Ingwie/NextStepRc-2.18/README.md

 *************************************************************
 *                      NEXTSTEPRC                           *
 *                                                           *
 *             -> Build your DIY MEGA 2560 TX                *
 *                                                           *
 *      Based on code named                                  *
 *      OpenTx - https://github.com/opentx/opentx            *
 *                                                           *
 *         Only avr code here for lisibility ;-)             *
 *                                                           *
 *  License GPLv2: http://www.gnu.org/licenses/gpl-2.0.html  *
 *                                                           *
 *************************************************************
