Ingwie/NextStepRc-2.18/documentation/NextStepRC_M2560/1_Electronics/MEGA2560_PinMapping.xls

Pin Number | Pin Name | Arduino Mapped Pin Name | Port | Pin | Gruvin9x | MEGA2560 | Function | Gruvin9x |  | MEGA2560
1 | PG5 ( OC0B ) | Digital pin 4 (PWM) | A | 0 | LCD Data 0 | LCD Data 0 | LCD Data 0 | A | 0 | A | 0
2 | PE0 ( RXD0/PCINT8 ) | Digital pin 0 (PWM) (RX0) | A | 1 | LCD Data 1 | LCD Data 1 | LCD Data 1 | A | 1 | A | 1
3 | PE1 ( TXD0 ) | Digital pin 1 (PWM) (TX0) | A | 2 | LCD Data 2 | LCD Data 2 | LCD Data 2 | A | 2 | A | 2
4 | PE2 ( XCK0/AIN0 ) |  | A | 3 | LCD Data 3 | LCD Data 3 | LCD Data 3 | A | 3 | A | 3
5 | PE3 ( OC3A/AIN1 ) | Digital pin 5 (PWM) | A | 4 | LCD Data 4 | LCD Data 4 | LCD Data 4 | A | 4 | A | 4
6 | PE4 ( OC3B/INT4 ) | Digital pin 2 (PWM) | A | 5 | LCD Data 5 | LCD Data 5 | LCD Data 5 | A | 5 | A | 5
7 | PE5 ( OC3C/INT5 ) | Digital pin 3 (PWM) | A | 6 | LCD Data 6 | LCD Data 6 | LCD Data 6 | A | 6 | A | 6
8 | PE6 ( T3/INT6 ) |  | A | 7 | LCD Data 7 | LCD Data 7 | LCD Data 7 | A | 7 | A | 7
9 | PE7 ( CLKO/ICP3/INT7 ) |  | B | 0 | SD CARD | SD CARD | LCD BkL | C | 0 | C | 2
10 | VCC | VCC | B | 1 | SD CARD | SD CARD | LCD CS | C | 1 | C | 3
11 | GND | GND | B | 2 | SD CARD | SD CARD | LCD RST | C | 2 | C | 4
12 | PH0 ( RXD2 ) | Digital pin 17 (PWM) | B | 3 | SD CARD | SD CARD | LCD A0 | C | 3 | C | 5
13 | PH1 ( TXD2 ) | Digital pin 16 (PWM) | B | 4 | ID 2 SW | Unused | LCD WR | C | 4 | C | 6
14 | PH2 ( XCK2 ) | (TX3) | B | 5 | TRN SW | Sim control | LCD RD | C | 5 | C | 7
15 | PH3 ( OC4A ) | Digital pin 6 (PWM)(RX3 ) | B | 6 | PPM out | PPM out | Key down | L | 0 | L | 0
16 | PH4 ( OC4B ) | Digital pin 7 (PWM)(TX2) | B | 7 | Speaker | Voice_busy | Key up | L | 1 | L | 1
17 | PH5 ( OC4C ) | Digital pin 8 (PWM)(RX2 ) | C | 0 | LCD BkL | ID 1 SW | Key right | L | 2 | L | 2
18 | PH6 ( OC2B ) | Digital pin 9 (PWM)(TX1) | C | 1 | LCD CS | ID 2 SW | Key left | L | 3 | L | 3
19 | PB0 ( SS/PCINT0 ) | Digital pin 53 (PWM)(RX1) | C | 2 | LCD RST | LCD BkL | Key MENU | L | 4 | L | 4
20 | PB1 ( SCK/PCINT1 ) | Digital pin 52 (PWM)(SDA) | C | 3 | LCD A0 | LCD CS | Key ESC | L | 5 | L | 5
21 | PB2 ( MOSI/PCINT2 ) | Digital pin 51 (PWM)(SCL) | C | 4 | LCD WR | LCD RST | Stick RH | K | 0 | K | 0
22 | PB3 ( MISO/PCINT3 ) | Digital pin 50 | C | 5 | LCD RD | LCD A0 | Stick LV | K | 1 | K | 1
23 | PB4 ( OC2A/PCINT4 ) | Digital pin 10 (PWM) | C | 6 | ELE DR SW | LCD WR | Stick RV | K | 2 | K | 2
24 | PB5 ( OC1A/PCINT5 ) | Digital pin 11 (PWM) | C | 7 | AIL DR SW | LCD RD | Stick LH | K | 3 | K | 3
25 | PB6 ( OC1B/PCINT6 ) | Digital pin 12 (PWM) | D | 0 | I2C_SCL | I2C_SCL | Pot 1 | K | 4 | K | 4
26 | PB7 ( OC0A/OC1C/PCINT7 ) | Digital pin 13 (PWM) | D | 1 | I2C_SDA | I2C_SDA | Pot 2 | K | 5 | K | 5
27 | PH7 ( T4 ) |  | D | 2 | Rot 2 A | Rot 2 A | Pot 3 | K | 6 | K | 6
28 | PG3 ( TOSC2 ) |  | D | 3 | Rot 2 B | Rot 2 B | U Batt | K | 7 | K | 7
29 | PG4 ( TOSC1 ) |  | D | 4 | Rot 1 push | - | LH_Trim_dwn | J | 0 | F | 7
30 | RESET | RESET | D | 5 | Rot 2 push | - | LH_Trim_up | J | 1 | F | 6
31 | VCC | VCC | D | 6 | Spare 1 | - | LV_Trim_dwn | J | 2 | F | 5
32 | GND | GND | D | 7 | Spare 2 | AIL DR SW | LV_Trim_up | J | 3 | F | 4
33 | XTAL2 | XTAL2 | E | 0 | Telemetry in | Telemetry in | RV_Trim_dwn | J | 4 | F | 3
34 | XTAL1 | XTAL1 | E | 1 | Telemetry out | Telemetry out | RV_Trim_up | J | 5 | F | 2
35 | PL0 ( ICP4 ) | Digital pin 49 | E | 2 | USB_D- | - | RH_Trim_dwn | J | 6 | F | 1
36 | PL1 ( ICP5 ) | Digital pin 48 | E | 3 | Buzzer | Voice_data | RH_Trim_up | J | 7 | F | 0
37 | PL2 ( T5 ) | Digital pin 47 | E | 4 | USB_D+ | Rot 1 A | ID 1 SW | G | 3 | C | 0
38 | PL3 ( OC5A ) | Digital pin 46 (PWM) | E | 5 | Rot 1 A | Rot 1 B | ID 2 SW | B | 4 | C | 1
39 | PL4 ( OC5B ) | Digital pin 45 (PWM) | E | 6 | Rot 1 B | - | TRN SW | B | 5 | L | 7
40 | PL5 ( OC5C ) | Digital pin 44 (PWM) | E | 7 | PPM in | PPM in | AIL DR SW | C | 7 | D | 7
41 | PL6 | Digital pin 43 | F | 0 | - | RH_Trim_up | ELE DR SW | C | 6 | L | 6
42 | PL7 | Digital pin 42 | F | 1 | - | LH_Trim_dwn | RUD DR SW | G | 0 | G | 0
43 | PD0 ( SCL/INT0 ) | Digital pin 21 (SCL) | F | 2 | - | RV_Trim_up | GEAR SW | G | 5 | G | 1
44 | PD1 ( SDA/INT1 ) | Digital pin 20 (SDA) | F | 3 | - | RV_Trim_dwn | THR CUT SW | G | 2 | G | 2
45 | PD2 ( RXDI/INT2 ) | Digital pin 19 | F | 4 | - | LV_Trim_up | Rot 1 A | E | 5 | E | 4
46 | PD3 ( TXD1/INT3 ) | Digital pin 18 | F | 5 | - | LV_Trim_dwn | Rot 1 B | E | 6 | E | 5
47 | PD4 ( ICP1 ) |  | F | 6 | - | LH_Trim_up | Rot 1 push | D | 4 | J | 0
48 | PD5 ( XCK1 ) |  | F | 7 | - | LH_Trim_dwn | Rot 2 A | D | 2 | D | 2
49 | PD6 ( T1 ) |  | G | 0 | RUD DR SW | RUD DR SW | Rot 2 B | D | 3 | D | 3
50 | PD7 ( T0 ) | Digital pin 38 | G | 1 | RF activated | GEAR SW | Rot 2 push | D | 5 | J | 1
51 | PG0 ( WR ) | Digital pin 41 | G | 2 | THR CUT SW | THR CUT SW | Buzzer | E | 3 | H | 3
52 | PG1 ( RD ) | Digital pin 40 | G | 3 | ID 1 SW | - | Speaker | B | 7 | H | 3
53 | PC0 ( A8 ) | Digital pin 37 | G | 4 | Sim control | - | Haptic (vib) | H | 2 | H | 0
54 | PC1 ( A9 ) | Digital pin 36 | G | 5 | Gear SW | Voice_clock | Voice_reset | H | 3 | H | 1
55 | PC2 ( A10 ) | Digital pin 35 | G | 6 | - | - | Voice_clock | H | 4 | G | 5
56 | PC3 ( A11 ) | Digital pin 34 | G | 7 | - | - | Voice_data | H | 5 | E | 3
57 | PC4 ( A12 ) | Digital pin 33 | H | 0 | - | Haptic (vib) | Voice_busy | H | 6 | B | 7
58 | PC5 ( A13 ) | Digital pin 32 | H | 1 | - | Voice_reset | PPM out | B | 6 | B | 6
59 | PC6 ( A14 ) | Digital pin 31 | H | 2 | Haptic (vib) | - | PPM in | E | 7 | E | 7
60 | PC7 ( A15 ) | Digital pin 30 | H | 3 | Voice_reset | Speaker/Buzzer | Sim control | G | 4 | B | 5
61 | VCC | VCC | H | 4 | Voice_clock | Hold power | Hold power | L | 7 | H | 4
62 | GND | GND | H | 5 | Voice_data | DSC activated | DSC activated | L | 6 | H | 5
63 | PJ0 ( RXD3/PCINT9 ) | Digital pin 15 | H | 6 | Voice_busy | RF activated | RF activated | G | 1 | H | 6
64 | PJ1 ( TXD3/PCINT10 ) | Digital pin 14 | H | 7 | - | - | Telemetry in | E | 0 | E | 0
65 | PJ2 ( XCK3/PCINT11 ) |  | I | 0 | - | - | Telemetry out | E | 1 | E | 1
66 | PJ3 ( PCINT12 ) |  | I | 1 | - | - | SD CARD | B | 0 | B | 0
67 | PJ4 ( PCINT13 ) |  | I | 2 | - | - | SD CARD | B | 1 | B | 1
68 | PJ5 ( PCINT14 ) |  | I | 3 | - | - | SD CARD | B | 2 | B | 2
69 | PJ6 ( PCINT 15 ) |  | I | 4 | - | - | SD CARD | B | 3 | B | 3
70 | PG2 ( ALE ) | Digital pin 39 | I | 5 | - | - | I2C_SCL | D | 0 | D | 0
71 | PA7 ( AD7 ) | Digital pin 29 | I | 6 | - | - | I2C_SDA | D | 1 | D | 1
72 | PA6 ( AD6 ) | Digital pin 28 | I | 7 | - | -
73 | PA5 ( AD5 ) | Digital pin 27 | J | 0 | LH_Trim_dwn | Rot 1 push
74 | PA4 ( AD4 ) | Digital pin 26 | J | 1 | LH_Trim_up | Rot 2 push
75 | PA3 ( AD3 ) | Digital pin 25 | J | 2 | LV_Trim_dwn | -
76 | PA2 ( AD2 ) | Digital pin 24 | J | 3 | LV_Trim_up | -
77 | PA1 ( AD1 ) | Digital pin 23 | J | 4 | RV_Trim_dwn | -
78 | PA0 ( AD0 ) | Digital pin 22 | J | 5 | RV_Trim_up | -
79 | PJ7 |  | J | 6 | RH_Trim_dwn | -
80 | VCC | VCC | J | 7 | RH_Trim_up | -
81 | GND | GND | K | 0 | Stick RH | Stick RH
82 | PK7 ( ADC15/PCINT23 ) | Analog pin 15 | K | 1 | Stick LV | Stick LV
83 | PK6 ( ADC14/PCINT22 ) | Analog pin 14 | K | 2 | Stick RV | Stick RV
84 | PK5 ( ADC13/PCINT21 ) | Analog pin 13 | K | 3 | Stick LH | Stick LH
85 | PK4 ( ADC12/PCINT20 ) | Analog pin 12 | K | 4 | Pot 1 | Pot 1
86 | PK3 ( ADC11/PCINT19 ) | Analog pin 11 | K | 5 | Pot 2 | Pot 2
87 | PK2 ( ADC10/PCINT18 ) | Analog pin 10 | K | 6 | Pot 3 | Pot 3
88 | PK1 ( ADC9/PCINT17 ) | Analog pin 9 | K | 7 | U Batt | U Batt
89 | PK0 ( ADC8/PCINT16 ) | Analog pin 8 | L | 0 | Key down | Keys
90 | PF7 ( ADC7/PCINT15 ) | Analog pin 7 | L | 1 | Key up | Keys
91 | PF6 ( ADC6/PCINT14 ) | Analog pin 6 | L | 2 | Key right | Keys
92 | PF5 ( ADC5/TMS ) | Analog pin 5 | L | 3 | Key left | Keys
93 | PF4 ( ADC4/TMK ) | Analog pin 4 | L | 4 | Key MENU | Key MENU
94 | PF3 ( ADC3 ) | Analog pin 3 | L | 5 | Key ESC | Key ESC
95 | PF2 ( ADC2 ) | Analog pin 2 | L | 6 | DSC activated | ELE DR SW
96 | PF1 ( ADC1 ) | Analog pin 1 | L | 7 | Hold power | TRN SW
97 | PF0 ( ADC0 ) | Analog pin 0
98 | AREF | Analog Reference
99 | GND | GND
100 | AVCC | VCC
