Ingwie/NextStepRc-2.18/documentation/NextStepRC_M2560/1_Electronics/KS108(fr).xls

MEGA2560 | KS108
Lcd_Data_0 | DB0
Lcd_Data_1 | DB1
Lcd_Data_2 | DB2
Lcd_Data_3 | DB3
Lcd_Data_4 | DB4
Lcd_Data_5 | DB5
Lcd_Data_6 | DB6
Lcd_Data_7 | DB7
Lcd_RD | E
Lcd_WR | CS2 (ou CS1 si affichage inversé)
Lcd_A0 | D/I (ou RS)
Lcd_RST | RST
Lcd_CS | CS1 (ou CS2 si affichage inversé)
Lcd_Light | A (via une résistance de 100 ohms), K à la masse. ou montage à transistor)
 | R/W : Non connectée au méga. Reliée à la masse via une résistance de 1kohms
 | VSS (masse)
 | VDD (+5V)
 | VEE (voir schéma)
 | VR (voir schéma)
