Ingwie/NextStepRc-2.18/documentation/NextStepRC_M2560/1_Electronics/MEGA2560_Listing.xls

Board | Label | Qty | Manufacturer | Part Number | Description | Case | Implantation | Side | Points | Total pts | Comment
- | - | 1 | - | - | 2 mm plywood 250 x 500 mm | - | - | - | - | - | Prefere marine or aircraft plywood
- | - | 1 | Funduino, SaintSmart | MEGA2560 | Arduino Mega2560 clone (http://www.ebay.fr/itm/291335218312) | - | - | - | - | - | Main board (prefer with CH340G serial driver) (http://www.ebay.fr/itm/151303481964)
- | - | 2 | Samsung, Panasonic, etc. | - | 18650 round Li-Ion with PCB (http://fr.aliexpress.com/item/-/32257563308.html) | - | - | - | - | - | 2400 to 3400 mAh
- | - | 1 | - | - | HF module (2.4 GHz, 433 MHz, etc.) | - | - | - | - | - | PPM positive or negative shift, up to 16 channels + telemetry
- | - | 0 to 1 | - | - | RS232 to TTL converter (MAX3232) (http://www.ebay.fr/itm/221484714177) | - | - | - | - | - | For FrSky telemetry (if no "direct TTL" modification)
- | - | 1 | - | - | USBASP programmer (http://www.ebay.com/sch/i.html?_from=R40&_nkw=usbasp&_sacat=0) | - | - | - | - | - | For bootloader and fuses flash
- | - | 1 | Artronic | 128064MN19-FHW | LCD 128x64 ST7565R (http://www.ebay.fr/itm/321632747032) | - | - | - | - | - | LCD (large, 3.3V, to use with M2560-1 board)
- | - | 1 | Zolen | ZLE12864A | LCD 128x64 ST7565P (http://fr.aliexpress.com/item/4pcs-New-12864-128x64-Graphic-LCD-Display-module-ST7565P-Free-Shipping/1383335383.html) | - | - | - | - | - | LCD (small, 5V)
- | - | 1 | Turnigy | 9171000250 | 9XR gimbal left (http://www.hobbyking.com/hobbyking/store/__39505__transmitter_gimbal_set_left_turnigy_9xr_transmitter_mode_1.html) | - | - | - | - | - | Gimbal basic (direct connection on MEGA)
- | - | 1 | Turnigy | 9171000248 | 9XR gimbal right (http://www.hobbyking.com/hobbyking/store/__39503__Transmitter_Gimbal_Set_Right_Turnigy_9XR_Transmitter_Mode_1.html) | - | - | - | - | - | Gimbal basic (direct connection on MEGA)
- | - | 2 | Hitec | - | Aurora9 gimbal (http://www.robotshop.com/en/axis-joystick-gim.html) | - | - | - | - | - | Gimbal option (to use with M2560-5 board)
 | - | 0 to 2 | - | - | PS2 gimbal (http://www.aliexpress.com/item/Free-Shipping-20PCS-LOT-Dual-axis-XY-Joystick-Module-For-Arduino-ps2-Joystick-Module/1882818018.html) | - | - | - | - | - | Gimbal option
- | - | 1 | Turnigy | 9171000045 | M3 sticks pair (http://www.hobbyking.com/hobbyking/store/__23754__Alloy_Anti_Slip_TX_Control_Sticks_Short_Futaba_TX_.html) | - | - | - | - | - | Fit basic or option gimbal
- | - | 0 to 1 | - | - | on-off-on switch | - | - | - | - | - | ID0/1/2 switch
- | - | 0 to 5 | - | - | off-on switch | - | - | - | - | - | DR_e, DR_a, DR_r, ThCut, Gear switches
- | - | 0 to 1 | - | - | off-(on) switch | - | - | - | - | - | TRN (momentary, classic switch)
- | - | 0 to 1 | APEM | MJTP1230 | SPST tactile switch | - | - | - | - | - | TRN (momentary, small swtich), or other(s) switch(es) with T flip-flop virtual switch
- | - | 1 | ALPS | SKQUAAA010 | 4 way navigation switch | - | - | - | - | - | 4 way navigation (if no scroll navigation with M2560-1&2 boards)
- | - | 0 or 2 | APEM | MJTP1230 | SPST tactile switch | - | - | - | - | - | OK/ESC buttons (if no scroll navigation with M2560-1&2 boards)
- | - | 3 | - | - | JST BEC female connector plug | - | - | - | - | - | Charge or external supply connecteur + internal power wiring
- | - | 1 | - | - | JST BEC male connector plug | - | - | - | - | - | Internal power wiring
- | SW1 | 1 | Multicomp | R13-548B-05-BB | SPST push-button | - | - | - | - | - | Main power swtitch (basic)
- | SW1 | 1 | - | - | SPST metal + led push-button (http://www.ebay.fr/sch/i.html?_from=R40&_sacat=0&_nkw=metal+led+switch&_sop=15) | - | - | - | - | - | Main power swtitch (option)
- | - | 0.5 m | - | - | 28 or 30 AWG flap ribbon cable, 20 wires | - | - | - | - | - | LCD, switches and rotary encoders wiring
- | - | 1 | DB Products | PK-21N30-WQ | Piezoelectronic buzzer | - | - | - | - | - | Buzzer with built-in drive circuit
- | - | 0 to 1 | - | - | Mini SD-Card socket for Arduino (http://www.ebay.fr/itm/221485468743) | - | - | - | - | - | Option
- | - | 0 to 1 | - | - | Real Time Clock (http://www.ebay.fr/itm/251730989006) | - | - | - | - | - | Option
M2560-1_LCD | Q1 | 1 | ON Semiconductor | MMFT960T1 | 300 mA 60 Volts N−Channel MOSFET | SOT-223 | SMD | Top | 4 | 4
M2560-1_LCD | U3 | 1 | Microchip | MCP1826S3302 | 3.3V 1A Low drop positive regulator | SOT-223 | SMD | Top | 4 | 4
M2560-1_LCD | R4 | 14 | - | - | 5.1 Kohms 1% resistor | 1206 | SMD | Top | 2 | 28
M2560-1_LCD | R6 | 14 | - | - | 10 Kohms 1% resistor | 1206 | SMD | Top | 2 | 28
M2560-1_LCD | C1 | 2 | - | - | 100 nF 10% 63 V Capacitor X7R | 1206 | SMD | Top | 2 | 4
M2560-2_RotEnc1 | - | 1 | C&K | TSWB-3N-CB111 LFS | 4 ways navigation switch + scroll + pushbutton | - | Through hole | Bottom | 9 | 9 | Rotary encoder 1 & navigation (arrows + Menu)
M2560-2_RotEnc1 | R1 | 7 | - | - | 200 ohms 1% resistor | 1206 | SMD | Top | 2 | 14
M2560-2_RotEnc1 | R4 | 2 | - | - | 5.1 Kohms 1% resistor | 1206 | SMD | Top | 2 | 4
M2560-2_RotEnc1 | C1 | 7 | - | - | 100 nF 10% 63 V Capacitor X7R | 1206 | SMD | Top | 2 | 14
M2560-3_RotEnc2 | - | 1 | C&K | TSWA-3N-CB11 LFS | Scroll + pushbutton | - | Through hole | Bottom | 4 | 4 | Rotary encoder 2 & navigation (Esc) or alone rotary (Rot_x + Push_x)
M2560-3_RotEnc2 | R1 | 3 | - | - | 200 ohms 1% resistor | 1206 | SMD | Top | 2 | 6
M2560-3_RotEnc2 | R4 | 2 | - | - | 5.1 Kohms 1% resistor | 1206 | SMD | Top | 2 | 4
M2560-3_RotEnc2 | C1 | 3 | - | - | 100 nF 10% 63 V Capacitor X7R | 1206 | SMD | Top | 2 | 6
M2560-4_Trim&switches | - | 2 | ALPSS | SKQUAAA01 | 4 ways navigation swtich | - | Through hole | Bottom | 6 | 12
M2560-4_Trim&switches | R1 | 8 | - | - | 200 ohms 1% resistor | 1206 | SMD | Top | 2 | 16
M2560-4_Trim&switches | C1 | 8 | - | - | 100 nF 10% 63 V Capacitor X7R | 1206 | SMD | Top | 2 | 16
M2560-5_Sticks(basic) | - | 4 | TE Connectivity | 292161-3 | 2 mm 3 pins connector header | - | Through hole | Bottom | 3 | 12
M2560-5_Sticks(basic) | - | 1 | - | - | 2.54 mm connector header | - | Through hole | Top | 4 | 4 | 4 pins
M2560-5_Sticks(basic) | U2 | 1 | Microchip | MCP6004 | Low-Power Op Amp | SOIC-14 | SMC | Top | 14 | 14
M2560-5_Sticks(basic) | R2 | 4 | - | - | 2.2 Kohms 1% resistor | 1206 | SMD | Top | 2 | 8
M2560-5_Sticks(basic) | R6 | 8 | - | - | 10 Kohms 1% resistor | 1206 | SMD | Top | 2 | 16
M2560-5_Sticks(full) | - | 4 | TE Connectivity | 292161-3 | 2 mm 3 pins connector header | - | Through hole | Bottom | 3 | 12
M2560-5_Sticks(full) | - | 1 | - | - | 2.54 mm connector header | - | Through hole | Top | 4 | 4 | 21 pins
M2560-5_Sticks(full) | U2 | 1 | Microchip | MCP6004 | Low-Power Op Amp | SOIC-14 | SMC | Top | 14 | 14
M2560-5_Sticks(full) | R2 | 4 | - | - | 2.2 Kohms 1% resistor | 1206 | SMD | Top | 2 | 8
M2560-5_Sticks(full) | R3 | 1 | - | - | 2.7 Kohms 1% resistor | 1206 | SMD | Top | 2 | 2
M2560-5_Sticks(full) | R4 | 1 | - | - | 5.1 Kohms 1% resistor | 1206 | SMD | Top | 2 | 2
M2560-5_Sticks(full) | R6 | 8 | - | - | 10 Kohms 1% resistor | 1206 | SMD | Top | 2 | 16
M2560-6_PPM&Power | - | 1 | - | - | 2.54 mm connector header | - | Through hole | Bottom | 4 | 4 | 33 pins
M2560-6_PPM&Power | U1 | 1 | On Semiconductor | MC14066B | Quad multiplexer | SOIC-14 | SMD | Top | 14 | 14 | Trainer port selector (in / out)
M2560-6_PPM&Power | Q1 | 1 | ON Semiconductor | MMFT960T1 | 300 mA 60 Volts N−Channel MOSFET | SOT-223 | SMD | Top | 4 | 4
M2560-6_PPM&Power | Q2 | 1 | Fairchild Semicon. | NDT2955 | 2.5 A 60 Volts P−Channel MOSFET | SOT-223 | SMD | Top | 4 | 4
M2560-6_PPM&Power | D1 | 4 | MCC | MBR0520LT1G | 0.5 A 20 V low drop Schottky | SOD-123 | SMD | Top | 2 | 8
M2560-6_PPM&Power | R1 | 1 | - | - | 200 ohms 1% resistor | 1206 | SMD | Top | 2 | 2
M2560-6_PPM&Power | R3 | 1 | - | - | 2.7 Kohms 1% resistor | 1206 | SMD | Top | 2 | 2
M2560-6_PPM&Power | R4 | 5 | - | - | 5.1 Kohms 1% resistor | 1206 | SMD | Top | 2 | 10
M2560-6_PPM&Power | R5 | 2 | - | - | 6.8 Kohms 1% resistor | 1206 | SMD | Top | 2 | 4
M2560-6_PPM&Power | R6 | 2 | - | - | 10 Kohms 1% resistor | 1206 | SMD | Top | 2 | 4
M2560-6_PPM&Power | R7 | 2 | - | - | 100 Kohms 1% resistor | 1206 | SMD | Top | 2 | 4
M2560-6_PPM&Power | C1 | 1 | - | - | 100 nF 10% 63 V Capacitor X7R | 1206 | SMD | Top | 2 | 2
M2560-6_PPM&Power | SW2 | 1 | CUI Inc | MD-40SV | Mini DIN 4 pins socket | - | - | - | - | - | Trainer port
M2560-6_PPM&Power | SW2 | 1 | CUI Inc | MD-40 | Mini DIN 4 pins plug | - | - | - | - | - | Trainer port
