Ingwie/NextStepRc-2.18/(list of files, cad)

Other CAD files:
documentation/NextStepRC_M2560/2_Case/MEGA2560_Case.dxf
