Ingwie/NextStepRc-2.18/documentation/NextStepRC_M2560/3_Flashing/MEGA2560_FlashProcedure.pdf

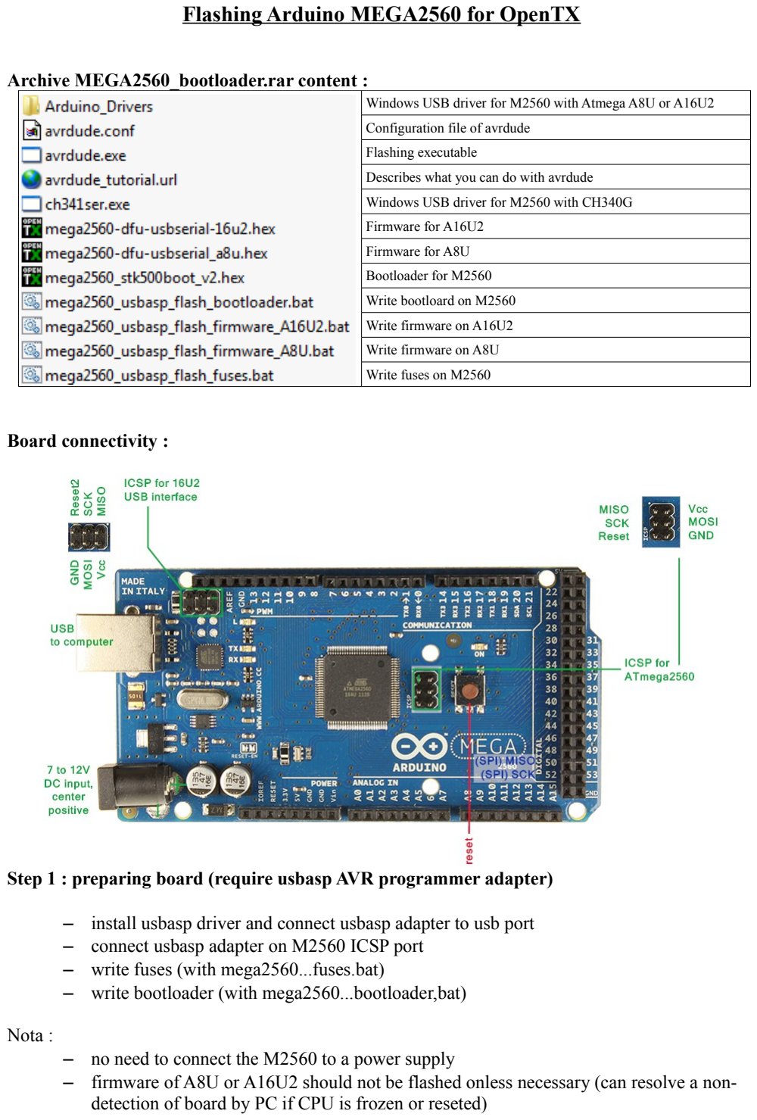
[picture p3: page 1]

Flashing Arduino MEGA2560 for OpenTX

Archive MEGA2560_bootloader.rar content :
Windows USB driver for M2560 with Atmega A8U or A16U2 Configuration file of avrdude
Flashing executable
Describes what you can do with avrdude
Windows USB driver for M2560 with CH340G Firmware for A16U2
Firmware for A8U
Bootloader for M2560
Write bootloard on M2560
Write firmware on A16U2
Write firmware on A8U
Write fuses on M2560

Board connectivity :

Step 1 : preparing board (require usbasp AVR programmer adapter)

– install usbasp driver and connect usbasp adapter to usb port – connect usbasp adapter on M2560 ICSP port
– write fuses (with mega2560...fuses.bat)
– write bootloader (with mega2560...bootloader,bat)

Nota :
– no need to connect the M2560 to a power supply
– firmware of A8U or A16U2 should not be flashed onless necessary (can resolve a nondetection of board by PC if CPU is frozen or reseted)

Step 2 : connecting board to USB
CH340G board | A8U or A16U2 board
- execute « ch341ser.exe » to install driver • connect M2560 on one USB port • Windows should automatically configure driver | • connect M2560 on one USB port • Windows opens an installation panel • choose manually the driver « arduino.inf » in the folder « Arduino_Drivers » provided

– verify on Windows device management (direct access : devmgmt.msc) if device works, and witch com is used (com1, com2, etc.)

Step 3 : setting Companion communication

– launch OpenTX Companion 2.1
– open the « Configure communications » menu
– set the following parameters (with the right com) :

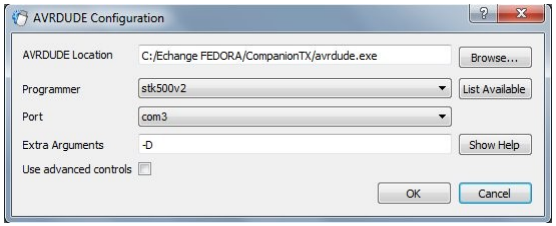
[picture p4: figure]

– A8U or A16U2 board : for each firmware or eeprom access (read or flash), M2560 must be reset just before (press reset button is board is already connected, or simply plug the board on USB)
– CH340G board : USB communication remains open after startup, no need to reset
Step 3 : setting Companion Radio Profile and and Application Settings

– go to the « Settings » menu, click « Settings »
– select « Radio Profile » tab
– check LCD, language and options needed :

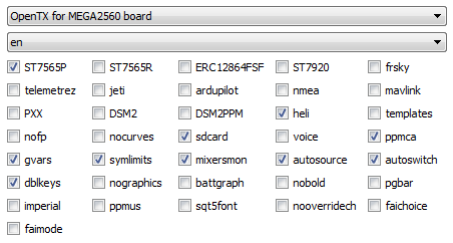
[picture p5: figure]

– select « Application Settings » tab
– open a folder for eeprom backup (don't check « Enable auto... » for the moment)
Step 4 : first flash with Companion

– go to « File » menu, click « Download »
– download firmware
– go to « Read/Write » menu, click « Write Firmware to Radio »
– load the downloaded firmware
– uncheck (for the moment) « Backup and restore Models ans Settings »

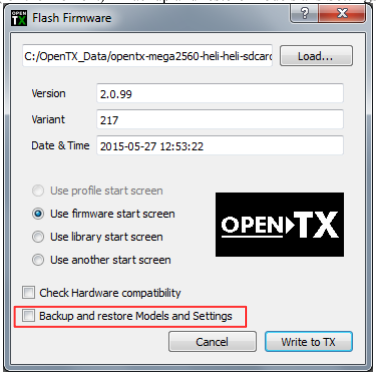
[picture p6: figure]

– write to TX...
– unplug the radio form USB port
– run the radio or plug it to usb port
– OpenTX should start and launch the init sequence (formatting eeprom then calibrate the sticks)
– enjoy... :)
