Ingwie/NextStepRc-2.18/documentation/NextStepRC_M2560/Readme.txt

Important note :

OpenTX-Mega2560 and NextStepRC projects are copyrighted under Creative Commons Attribution-NoDerivs licence (CC BY-ND).
For commercial purpose or derivated products, please contact the authors.
