Ingwie/NextStepRc-2.18/documentation/Other build link/Transmitter build by Mousse.txt

http://www.sitakiki.fr/modnaval/nextsteprc.htm
