Ingwie/NextStepRc-2.18/documentation/NextStepRC_M2560/2_Case/MEGA2560_Case_black.pdf

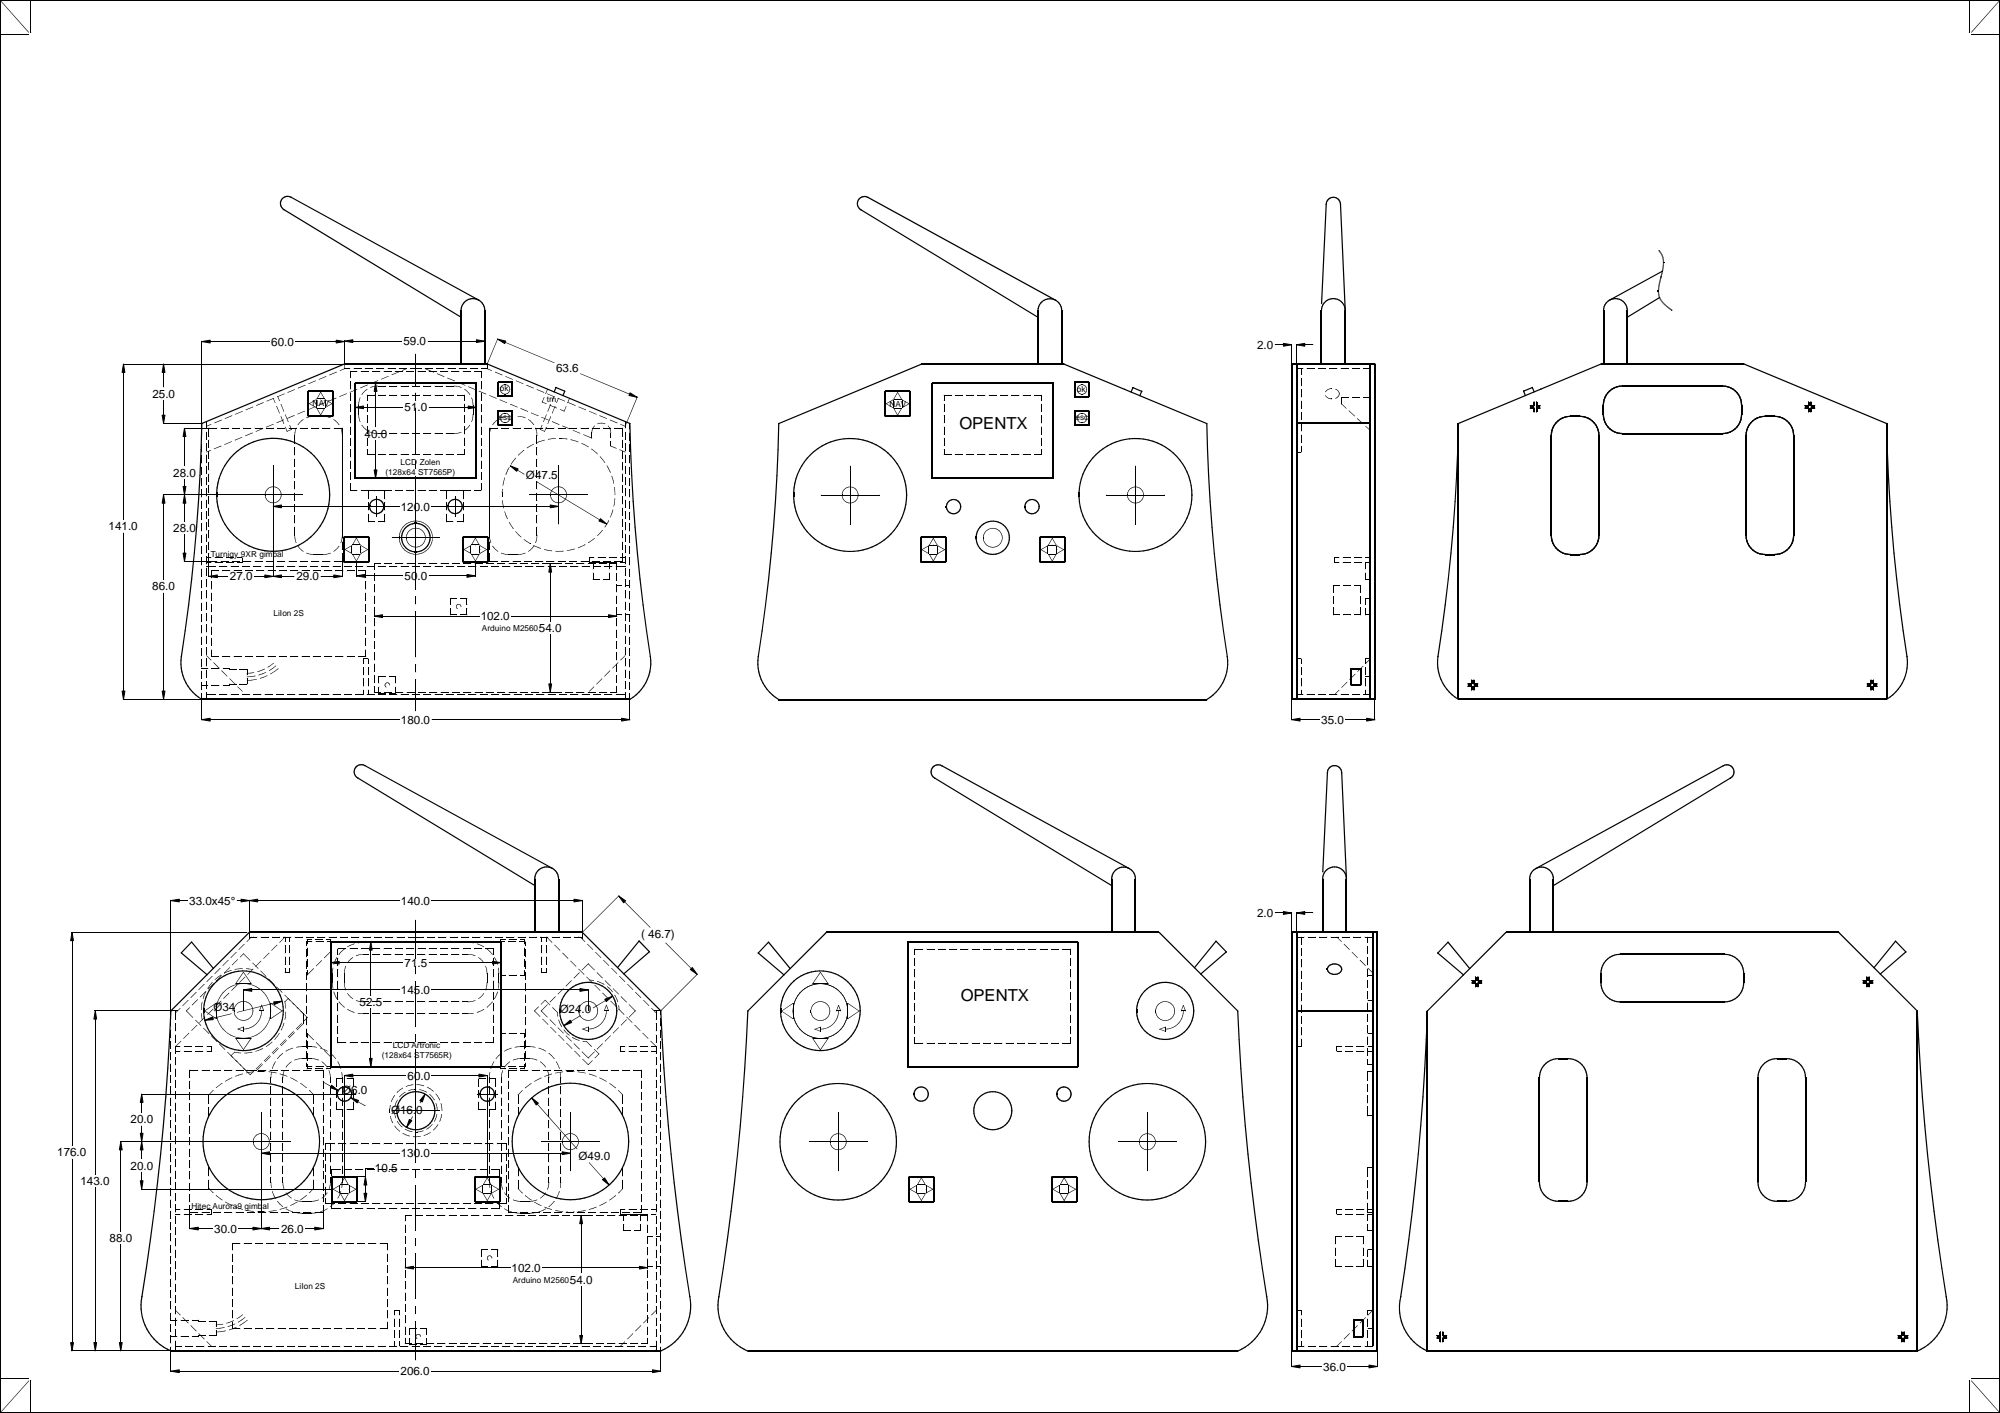
[picture p21: page 1]
OPENTX; LCD Artronic (128x64 ST7565R); LCD Zolen; esc; NAV; trn; Hitec Aurora9 gimbal; Turnigy 9XR gimbal; Arduino M2560; LiIon 2S; Arduino M2560 LiIon 2S

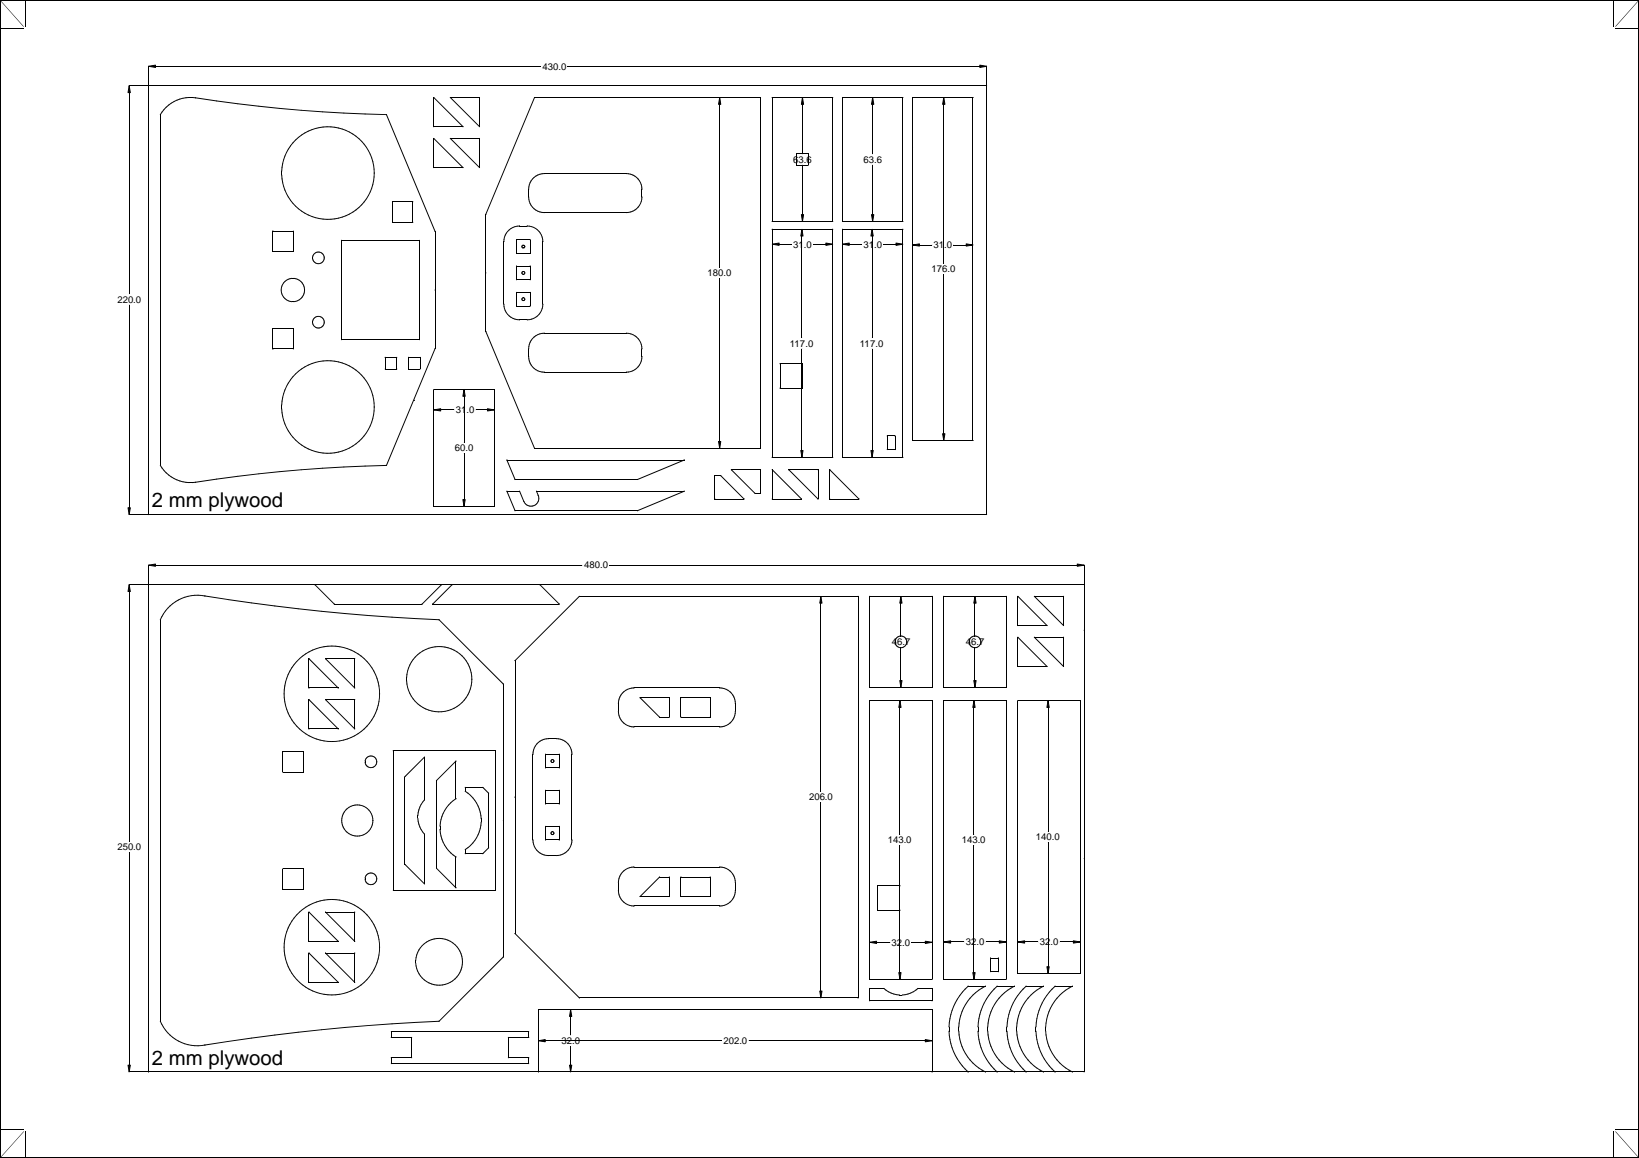
[picture p22: page 2]
2 mm plywood
