Ingwie/NextStepRc-2.18/documentation/NextStepRC_M2560/1_Electronics/MEGA2560.sch

## KiCad design documentation/NextStepRC_M2560/1_Electronics/MEGA2560.sch (2016-07-11)

Schematic: MEGA2560.sch

Parts:
1, 5V: VCC
+: CONN_1
-: CONN_1
.: Push
C1: 100n
D1: MBR0520
GND: GND
Pxx: POT
Q1: MMFT960
Q2: NDT2955
R1: 200
R2: 2.2K
R3: 2.7K
R4: 5.1K
R5: 6.8K
R6: 10K
R7: 100K
R8: 100
RF_Module: CONN_1
ROT_ENC_x: A
SW1: Power switch
SW2: Jack plugged
SW_xx: .
Stick: POT
U1: 4066
U2: MCP6004
U3: MCP1826 3.3V
U4: TLP290 / TLP620; .

Notes on the sheet:
JACK
Power management
Battery voltage reading
Rotary encoders (x2)
Aurora 9X sticks amplification (x4)
PPM management
LCD backlight (3.3V)
3.3V device (LCD, Somo14/WTV20, ...)
Switches, trims & keybs deboucing (x22)
Pinout caption :
LCD supported : ST7565P, ST7565R, ERC12864FSF, ST7920, KS108 Protocol = 6800, 8 bits parallel mode LCD pinout labels (may differ, depending of brand) : RD = Read or Enable on ST7920 WR = Write or Write(0)/Read(1) on ST7920 or CS2 on KS108 A0 = R/S (register select) or D/I (data/instruction select) 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
NOTA : all features are optional. M2560 can properly work without PPM / power management, switch deboucing, stick voltage protection or rotary encoder. Minimum requirement is just LCD and navigation keys. Some switches could be usefull, especially for flight conditions, but not fundamental.
LCD direct backlight (5V, 20 mA)
Stick anti-jitter filter
Unused analog pin
Pin 9, can be soldered with pin 8 (unused)
Flash insulation
R6 is optional
