Ingwie/NextStepRc-2.18/radio/src/targets/mega2560/board_mega2560.h

/*
 *************************************************************
 *                      NEXTSTEPRC                           *
 *                                                           *
 *             -> Build your DIY MEGA 2560 TX                *
 *                                                           *
 *      Based on code named                                  *
 *      OpenTx - https://github.com/opentx/opentx            *
 *                                                           *
 *         Only avr code here for lisibility ;-)             *
 *                                                           *
 *  License GPLv2: http://www.gnu.org/licenses/gpl-2.0.html  *
 *                                                           *
 *************************************************************
 */

#ifndef _BOARD_MEGA2560_H_
#define _BOARD_MEGA2560_H_

#include "../common_avr/board_avr.h"


//Mods
#define ROTENC_DIV2 // rotenc resolution/2
#define FATFSTINY // Reduce SDdriver buffer size

// Keys
#define KEYS_GPIO_REG_MENU        pinl
#define KEYS_GPIO_PIN_MENU        (1<<4)
#define KEYS_GPIO_REG_EXIT        pinl
#define KEYS_GPIO_PIN_EXIT        (1<<5)
#define KEYS_GPIO_REG_RIGHT       pinl
#define KEYS_GPIO_PIN_RIGHT       (1<<2)
#define KEYS_GPIO_REG_LEFT        pinl
#define KEYS_GPIO_PIN_LEFT        (1<<3)
#define KEYS_GPIO_REG_UP          pinl
#define KEYS_GPIO_PIN_UP          (1<<1)
#define KEYS_GPIO_REG_DOWN        pinl
#define KEYS_GPIO_PIN_DOWN        (1<<0)

// Trims
#define TRIMS_GPIO_REG_LHL        pinf
#define TRIMS_GPIO_PIN_LHL        (1<<7)
#define TRIMS_GPIO_REG_LVD        pinf
#define TRIMS_GPIO_PIN_LVD        (1<<5)
#define TRIMS_GPIO_REG_RVU        pinf
#define TRIMS_GPIO_PIN_RVU        (1<<2)
#define TRIMS_GPIO_REG_RHL        pinf
#define TRIMS_GPIO_PIN_RHL        (1<<1)
#define TRIMS_GPIO_REG_LHR        pinf
#define TRIMS_GPIO_PIN_LHR        (1<<6)
#define TRIMS_GPIO_REG_LVU        pinf
#define TRIMS_GPIO_PIN_LVU        (1<<4)
#define TRIMS_GPIO_REG_RVD        pinf
#define TRIMS_GPIO_PIN_RVD        (1<<3)
#define TRIMS_GPIO_REG_RHR        pinf
#define TRIMS_GPIO_PIN_RHR        (1<<0)

#define TIMER_16KHZ_VECT          TIMER2_OVF_vect
#define COUNTER_16KHZ             TCNT2
#define TIMER_10MS_VECT           TIMER2_COMPA_vect
#define TIMER_10MS_COMPVAL        OCR2A
#define PAUSE_10MS_INTERRUPT()    TIMSK2 &= ~(1<<OCIE2A)
#define RESUME_10MS_INTERRUPT()   TIMSK2 |= (1<<OCIE2A)
#define PAUSE_PPMIN_INTERRUPT()   TIMSK3 &= ~(1<<ICIE3)
#define RESUME_PPMIN_INTERRUPT()  TIMSK3 |= (1<<ICIE3)

#define SLAVE_MODE()              ~PINH & (1<<INP_H_RF_Activated)
#define JACK_PPM_OUT()            PORTB &= ~(1<<OUT_B_SIM_CTL)
#define JACK_PPM_IN()             PORTB |= (1<<OUT_B_SIM_CTL)

// Backlight driver
#define backlightEnable()         PORTC |= (1<<OUT_C_LIGHT)
#define backlightDisable()        PORTC &= ~(1<<OUT_C_LIGHT)
#define isBacklightEnable()       PORTC & (1<<OUT_C_LIGHT)

// SD driver
#define sdDone()
#define SD_IS_HC()                (0)
#define SD_GET_SPEED()            (0)
#if !defined(SIMU)
bool sdMounted(void);
void sdMountPoll(void);
void sdPoll10ms(void);
#endif

// Switchs driver
#define INP_C_ID2                 1
#define INP_C_ID1                 0
#define INP_D_AileDR              7
#define INP_G_ThrCt               2
#define INP_G_Gear                1
#define INP_G_RuddDR              0
#define INP_L_ElevDR              6
#define INP_L_Trainer             7

// Servitudes driver
#define INP_E_PPM_IN              7    //not used (reserved)
#define INP_B_WTV_BUSY            7    //WTV20SD, not used (reserved)
#define OUT_B_PPM                 6
#define OUT_B_SIM_CTL             5
#define I_O_B_UNUSED              4    //unused was Buzzer
#define INP_D_I2C_SCL             1
#define INP_D_I2C_SDA             0
#define OUT_E_WTV_DATA            3    //WTV20SD
#define INP_E_TELEM_RX            1
#define OUT_E_TELEM_TX            0
#define OUT_G_WTV_CLK             5    //WTV20SD
#define INP_H_RF_Activated        6
#define INP_H_DSC_Activated       5    //not used, reserved for pwrCheck()
#define INP_H_Hold_Power          4    //not used, reserved for pwrCheck()
#define OUT_H_SpeakerBuzzer       3
#define OUT_H_WTV_RESET           1    //WTV20SD
#define OUT_B_JQ_SERIAL           7    //JQ6500
#define INP_B_JQ_BUSY             4    //JQ6500
#define OUT_H_HAPTIC              0

// Rotary encoders driver
#define INP_E_ROT_ENC_1_A         4
#define INP_E_ROT_ENC_1_B         5
#define INP_D_ROT_ENC_2_A         2
#define INP_D_ROT_ENC_2_B         3
#define INP_J_ROT_ENC_1_PUSH      0
#define INP_J_ROT_ENC_2_PUSH      1
#define REA_DOWN()                (~PINJ & (1<<INP_J_ROT_ENC_1_PUSH))
#define REB_DOWN()                (~PINJ & (1<<INP_J_ROT_ENC_2_PUSH))
#define ROTENC_DOWN()             (REA_DOWN() || REB_DOWN())

// LCD driver
#define PORTA_LCD_DAT            PORTA
#define PORTC_LCD_CTRL           PORTC
#if defined(LCD_KS108)              // (For KS108 LCD only) MEGA R/W pin always at 0 state in Opentx then
#define OUT_C_LCD_CS2            6  // use this pin to control second KS108 (CS2)
#else                               // and connect KS108 R/W pin to ground via a 1k resistor
#define OUT_C_LCD_RnW            6
#endif
#define OUT_C_LCD_E              7
#define OUT_C_LCD_A0             5
#define OUT_C_LCD_RES            4
#define OUT_C_LCD_CS1            3
#define OUT_C_LIGHT              2

// DBLKeys driver
#define KEYS_PRESSED()            (~PINL)

// Power driver
uint8_t pwrCheck();
void pwrOff();
#if defined(PWRMANAGE)
  #define UNEXPECTED_SHUTDOWN()   ((mcusr & (1 << WDRF)) || g_eeGeneral.unexpectedShutdown)
#else
  #define UNEXPECTED_SHUTDOWN()   (mcusr & (1 << WDRF))
#endif

// USB fake driver
#define usbPlugged()              false

// Haptic driver
#define hapticOn()                PORTH |=  (1 << OUT_H_HAPTIC)
#define hapticOff()               PORTH &= ~(1 << OUT_H_HAPTIC)

// Buzzer driver
#define buzzerOn()                PORTH |=  (1 << OUT_H_SpeakerBuzzer)
#define buzzerOff()               PORTH &= ~(1 << OUT_H_SpeakerBuzzer)

// Speaker driver
#if defined(AUDIO)
#define speakerOff()              TCCR4A &= ~(1 << COM4A0)
#define speakerOn()               TCCR4A |=  (1 << COM4A0)
#endif

// Voice driver

// WTV20SD
#define WTV20SD_Clock_on              PORTG |=  (1<<OUT_G_WTV_CLK)
#define WTV20SD_Clock_off             PORTG &= ~(1<<OUT_G_WTV_CLK)
#define WTV20SD_Data_on               PORTE |=  (1<<OUT_E_WTV_DATA)
#define WTV20SD_Data_off              PORTE &= ~(1<<OUT_E_WTV_DATA)
#define WTV20SD_Reset_on              PORTH |=  (1<<OUT_H_WTV_RESET)
#define WTV20SD_Reset_off             PORTH &= ~(1<<OUT_H_WTV_RESET)
#define WTV20SD_BUSY                  (PINB & (1<<INP_B_WTV_BUSY))
#define WTV20SD_CLK                   (PING & (1<<OUT_G_WTV_CLK))

//JQ6500
#define JQ6500_Serial_on              PORTB |=  (1<<OUT_B_JQ_SERIAL)
#define JQ6500_Serial_off             PORTB &= ~(1<<OUT_B_JQ_SERIAL)
#define JQ6500_BUSY                   (PINB & (1<<INP_B_JQ_BUSY))

// EEPROM driver
#if !defined(SIMU)
#define eepromReadBlock(a, b, c)  eeprom_read_block(a, (const void *)b, c)
#endif

#endif // _BOARD_MEGA2560_H_
