Ingwie/NextStepRc-2.18/radio/src/targets/stock/lcd_ks108_driver.cpp

/*
*************************************************************
*                      NEXTSTEPRC                           *
*                                                           *
*             -> Build your DIY MEGA 2560 TX                *
*                                                           *
*      Based on code named                                  *
*      OpenTx - https://github.com/opentx/opentx            *
*                                                           *
*         Only avr code here for lisibility ;-)             *
*                                                           *
*  License GPLv2: http://www.gnu.org/licenses/gpl-2.0.html  *
*                                                           *
*************************************************************
*/

#define NUMITERATIONFULLREFRESH  2

#define DISPLAY_SET_COLUMN       0x40
#define DISPLAY_SET_PAGE         0xB8
#define DISPLAY_SET_START        0XC0 
#define DISPLAY_ON_CMD           0x3F //or 3E
#define CS1_on                   PORTC_LCD_CTRL |=  (1<<OUT_C_LCD_CS1)
#define CS1_off                  PORTC_LCD_CTRL &= ~(1<<OUT_C_LCD_CS1)
#define CS2_on                   PORTC_LCD_CTRL |=  (1<<OUT_C_LCD_CS2)
#define CS2_off                  PORTC_LCD_CTRL &= ~(1<<OUT_C_LCD_CS2)
#define A0_on                    PORTC_LCD_CTRL |=  (1<<OUT_C_LCD_A0)
#define A0_off                   PORTC_LCD_CTRL &= ~(1<<OUT_C_LCD_A0)
#define E_on                     PORTC_LCD_CTRL |=  (1<<OUT_C_LCD_E)
#define E_off                    PORTC_LCD_CTRL &= ~(1<<OUT_C_LCD_E)

void lcdPulseEnable(void)
{
  E_on;
  _delay_us(8); //Was 4 on the first tested 
  E_off;
}

void lcdSendCtl(uint8_t val)
{
  PORTA_LCD_DAT = val;
  A0_off;
  lcdPulseEnable();
  A0_on;

}

static void LcdInitCommand()
{
  lcdSendCtl(DISPLAY_ON_CMD);
  lcdSendCtl(DISPLAY_SET_START);
}

void lcdInit()
{
  PORTC_LCD_CTRL &= ~(1<<OUT_C_LCD_RES);  //LCD reset
  _delay_us(20);
  PORTC_LCD_CTRL |= (1<<OUT_C_LCD_RES);  //LCD normal operation
  CS1_on;                                //Init KS108 who need hight level on CS pin
  CS2_on;
  LcdInitCommand();                      //Init the two KS in one time
  CS1_off;                               //Init KS108 who need low level on CS pin
  CS2_off;
  LcdInitCommand();
}

void lcdSetRefVolt(uint8_t val)
{
}

void lcdRefreshFast()
{
  REFRESHDURATION1  //Debug function if defined LCDDURATIONSHOW in opentx.h

  static uint8_t change = 0; // toggle left or right lcd writing
  uint8_t *p;
  if (!change){ CS2_off; CS1_on; p = displayBuf; change = 1;} // Right
  else{ CS1_off; CS2_on; p = displayBuf + 64; change = 0;} // Left
  
  for (uint8_t page=0; page < 8; page++) {
    lcdSendCtl(DISPLAY_SET_COLUMN); // Column addr 0
    lcdSendCtl( page | DISPLAY_SET_PAGE); //Page addr
    A0_on;
    for (coord_t x=64; x>0; --x) {
      PORTA_LCD_DAT = *p++;
      lcdPulseEnable();
    }
    p += 64;
  }
  A0_off;
  
  REFRESHDURATION2  //Debug function if defined LCDDURATIONSHOW in opentx.h

}

void lcdRefresh()
{
  for (uint8_t i=0; i < NUMITERATIONFULLREFRESH; i++) { lcdRefreshFast(); }
}
