Ingwie/NextStepRc-2.18/radio/src/targets/stock/lcd_driver.cpp

/*
 *************************************************************
 *                      NEXTSTEPRC                           *
 *                                                           *
 *             -> Build your DIY MEGA 2560 TX                *
 *                                                           *
 *      Based on code named                                  *
 *      OpenTx - https://github.com/opentx/opentx            *
 *                                                           *
 *         Only avr code here for lisibility ;-)             *
 *                                                           *
 *  License GPLv2: http://www.gnu.org/licenses/gpl-2.0.html  *
 *                                                           *
 *************************************************************
 */

#include "opentx.h"

#if defined(PCBSTD) && defined(VOICE)
volatile uint8_t LcdLock;
#define LCD_LOCK() LcdLock = 1
#define LCD_UNLOCK() LcdLock = 0
#else
#define LCD_LOCK()
#define LCD_UNLOCK()
#endif

#if defined(LCD_KS108)
#include "targets/stock/lcd_ks108_driver.cpp"
#elif defined(LCD_ST7920)
#include "targets/stock/lcd_st7920_driver.cpp"
#elif defined(LCD_SSD1306)
#include "targets/stock/lcd_ssd1306_driver.cpp"
#else
#include "targets/stock/lcd_default_driver.cpp"
#endif
