Ingwie/NextStepRc-2.18/radio/src/logs.cpp

/*
 *************************************************************
 *                      NEXTSTEPRC                           *
 *                                                           *
 *             -> Build your DIY MEGA 2560 TX                *
 *                                                           *
 *      Based on code named                                  *
 *      OpenTx - https://github.com/opentx/opentx            *
 *                                                           *
 *         Only avr code here for lisibility ;-)             *
 *                                                           *
 *  License GPLv2: http://www.gnu.org/licenses/gpl-2.0.html  *
 *                                                           *
 *************************************************************
 */

#include "opentx.h"
#include "ff.h"

FIL g_oLogFile = {0};
//const pm_char * g_logError = NULL; bracame not used ? why
uint8_t logDelay;

#define get2PosState(sw) (switchState(SW_ ## sw) ? -1 : 1)

#define get3PosState(sw) (switchState(SW_ ## sw ## 0) ? -1 : (switchState(SW_ ## sw ## 2) ? 1 : 0))

const pm_char *openLogs()
{
  // Determine and set log file filename
  FRESULT result;
  DIR folder;
  char filename[34]; // /LOGS/modelnamexxx-2013-01-01.log

  if (!sdMounted())
    return STR_NO_SDCARD;

  if (sdGetFreeSectors() == 0)
    return STR_SDCARD_FULL;

  // check and create folder here
  strcpy_P(filename, STR_LOGS_PATH);
  result = f_opendir(&folder, filename);
  if (result != FR_OK) {
    if (result == FR_NO_PATH)
      result = f_mkdir(filename);
    if (result != FR_OK)
      return SDCARD_ERROR(result);
  }

  filename[sizeof(LOGS_PATH)-1] = '/';
  memcpy(&filename[sizeof(LOGS_PATH)], g_model.header.name, sizeof(g_model.header.name));
  filename[sizeof(LOGS_PATH)+sizeof(g_model.header.name)] = '\0';

  uint8_t i = sizeof(LOGS_PATH)+sizeof(g_model.header.name)-1;
  uint8_t len = 0;
  while (i>sizeof(LOGS_PATH)-1) {
    if (!len && filename[i])
      len = i+1;
    if (len) {
      if (filename[i])
        filename[i] = idx2char(filename[i]);
      else
        filename[i] = '_';
    }
    i--;
  }

  if (len == 0) {
    uint8_t num = g_eeGeneral.currModel + 1;
    strcpy_P(&filename[sizeof(LOGS_PATH)], STR_MODEL);
    filename[sizeof(LOGS_PATH) + PSIZE(TR_MODEL)] = (char)((num / 10) + '0');
    filename[sizeof(LOGS_PATH) + PSIZE(TR_MODEL) + 1] = (char)((num % 10) + '0');
    len = sizeof(LOGS_PATH) + PSIZE(TR_MODEL) + 2;
  }

  char * tmp = &filename[len];

#if defined(RTCLOCK)
  tmp = strAppendDate(&filename[len]);
#endif

  strcpy_P(tmp, STR_LOGS_EXT);

  result = f_open(&g_oLogFile, filename, FA_OPEN_ALWAYS | FA_WRITE);
  if (result != FR_OK) {
    return SDCARD_ERROR(result);
  }

  if (f_size(&g_oLogFile) == 0) {
    writeHeader();
  }
  else {
    result = f_lseek(&g_oLogFile, f_size(&g_oLogFile)); // append
    if (result != FR_OK) {
      return SDCARD_ERROR(result);
    }
  }

  return NULL;
}

tmr10ms_t lastLogTime = 0;

void closeLogs()
{
  if (f_close(&g_oLogFile) != FR_OK) {
    // close failed, forget file
    g_oLogFile.fs = 0;
  }
  lastLogTime = 0;
}

getvalue_t getConvertedTelemetryValue(getvalue_t val, uint8_t unit)
{
  convertUnit(val, unit);
  return val;
}

void writeHeader()
{
#if defined(RTCLOCK)
  f_puts("Date,Time,", &g_oLogFile);
#else
  f_puts("Time,", &g_oLogFile);
#endif

#if defined(FRSKY)
  f_puts("Buffer,RX,TX,A1,A2,", &g_oLogFile);
#if defined(FRSKY_HUB)
  if (IS_USR_PROTO_FRSKY_HUB()) {
    f_puts("GPS Date,GPS Time,Long,Lat,Course,GPS Speed(kts),GPS Alt,Baro Alt(", &g_oLogFile);
    f_puts(TELEMETRY_BARO_ALT_UNIT, &g_oLogFile);
    f_puts("),Vertical Speed,Air Speed(kts),Temp1,Temp2,RPM,Fuel," TELEMETRY_CELLS_LABEL "Current,Consumption,Vfas,AccelX,AccelY,AccelZ,", &g_oLogFile);
  }
#endif
#if defined(WS_HOW_HIGH)
  if (IS_USR_PROTO_WS_HOW_HIGH()) {
    f_puts("WSHH Alt,", &g_oLogFile);
  }
#endif
#endif

  f_puts("Rud,Ele,Thr,Ail,P1,P2,P3,THR,RUD,ELE,3POS,AIL,GEA,TRN\n", &g_oLogFile);
}
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
