Ingwie/NextStepRc-2.18/(commit log)

2016-04-16 First commit : opentx 2.18 original
    [MODELE24-2014-07-11.csv, stlink-v2.cfg, stm32f2x_stlink.cfg, stm32f4x_stlink.cfg]
2016-04-17 New voice driver 32bit splash no eeprom version check no ppm polarity bug dos compilable ;-)
    [board_mega2560.cpp, board_mega2560.h, eeprom_rlc.cpp, lcd.cpp, lcd.h, opentx.h, popups.cpp, splash.cpp]
2016-05-01 Tuto de JPierre pour la compilation
2016-05-18 KS108 driver ingrate lcd_driver.cpp New FAR progmem splash companion compatible
2016-05-19 Splash Linux compilation bug (thanks Mentero ;-)
    [splash.cpp]
2016-05-19 Removing no 'NEXTSTEPRC' code for lisibility
    [stlink-v2.cfg, stm32f2x_stlink.cfg, stm32f4x_stlink.cfg]
2016-05-26 Clean again
    [stlink-v2.cfg, stm32f2x_stlink.cfg, stm32f4x_stlink.cfg]
2016-05-28 Rebuild broken code, add separate Lcd drivers
    [lcd_default_driver.cpp, lcd_driver.cpp, lcd_ks108_driver.cpp, lcd_st7920_driver.cpp]
2016-05-30 Add Pyral's Voice documentation Change files header (shortest)
    [adc_driver.cpp, ardupilot.cpp, audio_avr.cpp, bin_allocator.cpp, board_gruvin9x.cpp, board_mega2560.cpp, board_mega2560.h, board_stock.cpp]
2016-06-01 Add tools to generate audio files (FR)
    [system_sounds.csv]
2016-06-02 Makefile purge
    ARM CPU removed
2016-06-02 Documentation folder + M2560 files
    [MEGA2560.sch, MEGA2560_Case.dxf, MEGA2560_Listing.xls, MEGA2560_PinMapping.xls]
2016-06-02 FrSky ARM removed
2016-06-02 New batch to convert audio files-> Normalyse and cut silences
2016-06-08 Audio files script tested (__Compressad4)
    [system_sounds.csv]
2016-06-12 Remove arm if and case definitions
2016-06-15 ARM cleaning
2016-06-15 SCH updated with KS108
    [MEGA2560.sch]
2016-06-21 Voice bug "8 volt" without "volt" resolved -> WTV20SD doesn't send busy flag at constant time (depend of played file)
    "TADA" is now played all the time (at splash duration / 2)
    [opentx.cpp, voice.cpp]
2016-06-23 Remove ARM code
2016-06-26 WTV2OSD not always ready before sending "TADA3 -> Now wait for busy pin
2016-06-26 "M" Missing in "if defined(CPUM2560) condition
    [mixer.cpp]
2016-06-27 Another missing "M" in ifdef
    [mixer.cpp]
2016-07-03 MM2560 : Buzzer an Speaker share same pin now : H3
    [board_mega2560.cpp, board_mega2560.h, opentx.cpp]
2016-07-11 Schematics : LCD KS108 + buzzer pin + op-amp calculus
    [MEGA2560.sch]
2016-07-11 New mixer definition
    New code for delay, much simpler and usable with sticks
    Better implementation of trims for differential
    Differential corrected with XCURVES
    Activation of mix has its own zone
    Better mixer sequence
    Mixer interrupt correction
    LUA excluded
    [mixer.cpp, opentx.h]
2016-07-12 KS108 driver : Send init command CS pin on and CS pin off. -> Some KS108 module need hight level and other low level on CS pin.
2016-07-12 Update JP batfile and pinmapping.xls Remove wizard directory
    [MEGA2560_PinMapping.xls]
2016-07-14 Increase 'Enable' temporisation in KS108 driver for driving slow modules
2016-07-16 Save job : Rebuilds stick navigation option. -> Need some work to be finished (ie bug in readana screen)
    [board_mega2560.cpp, main_avr.cpp, opentx.cpp, opentx.h]
2016-07-31 Missing file ... -> Remove "#if LCD_W >= 212" code (not used with AVR Cpu)
    [eeprom_conversions.cpp]
2016-08-04 MEGA2560 : Switch all fonts to "Far progmem" call Bold specific is now possible with frsky option
2016-08-06 WTV20SD busy flag timer modification : -> Was not correctly checked when playing shortest soundfiles
    [voice.cpp]
2016-08-07 LCD KS108 wirring file : KS108(fr).xls
    [KS108(fr).xls]
2016-08-10 MEGA2560 & GRUVIN9X : Replace software I2C driver by hardware one. Save 18 bytes of code, better timing
    [board_gruvin9x.cpp, board_mega2560.cpp, rtc_driver.cpp]
2016-08-13 Correction of I2C hardware bug when no module is present. -> Enable pullup res. + optimisations
    [board_gruvin9x.cpp, board_mega2560.cpp, rtc_driver.cpp]
2016-08-16 Solution to "init I2C" bug without sdcard.
    -> Thank you Mentero !
    [board_mega2560.cpp]
2016-08-23 todo : change vcc opamp pin number in schematic
2016-08-29 Better sticks navigation (change as mode is set) Thanks JPZ for bug reporting
    [navigation.cpp]
2016-08-31 Buildaudiofiles : hightpass filter (200hz) and normalisation at -1 db. Thanks Mentero
2016-09-01 To be compatible with all mega board : Switch JQ6500 pins : JQ6500Data->B7 JQ6500Busy->B4 Change buffer size to 16 prompts
2016-09-03 Add New screen Oled I2C SSD1306 switch I2C speed 400khz -> 800khz Modify RTC code array Modify all the LCD refresh functions : All the sreen have the same now !!!
    Be carefull to test !!
2016-09-03 SSD1306 : Missing file + increase lcdRefreshFast speed : Now 4.18mS :) (I2C mode)
    [lcd_ssd1306_driver.cpp]
2016-09-05 JQ6500 PCB by Pyrall Thank you Christian ;-)
2016-09-05 Kicad_JQ6500 by Pyrall !!!
2016-09-07 ST7920 driver acceleration (lcdRefreshFast -> approx. 6mS)
