Ingwie/NextStepRc-2.18/(notices)

Notices in the files:
documentation/NextStepRC_M2560/1_Electronics/MEGA2560.sch:
Copyright F. Aguerre
